emilerenaud/6DOF-Robotic-Arm/README.md

# 6DOF Robotic Arm

We are developing a 6 degree of freedom robotic arm based on an existing model (link for the model: https://www.thingiverse.com/thing:3327968). The project is still in development. The repo contains information about the components that were used, the code and the hardware.
