emilerenaud/6DOF-Robotic-Arm/Paperwork/Factures/commande stepper moteur aliexpress.png

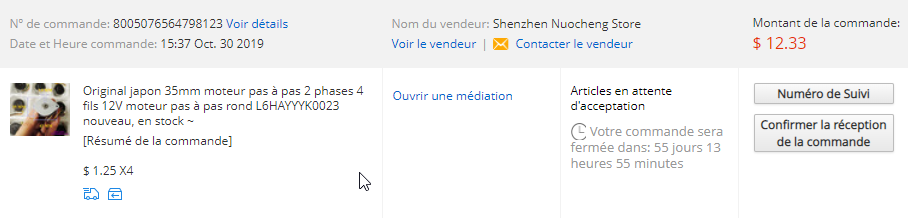
Paperwork/Factures/commande stepper moteur aliexpress.png
