emilerenaud/6DOF-Robotic-Arm/Paperwork/Factures/facture accesD stepper moteur aliexpress.png

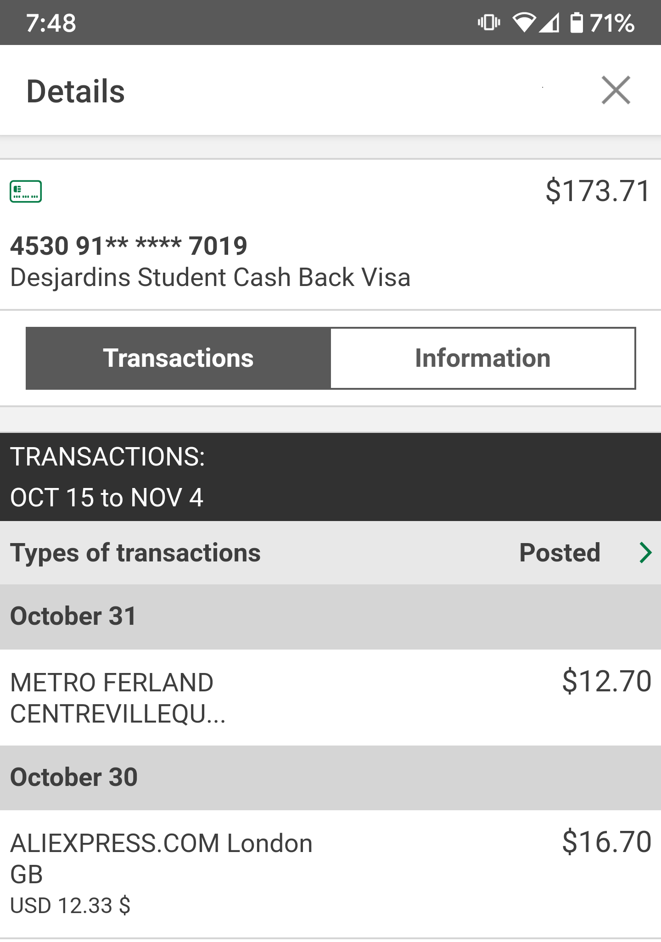
Paperwork/Factures/facture accesD stepper moteur aliexpress.png
