emilerenaud/6DOF-Robotic-Arm/Paperwork/Schémas/global.png

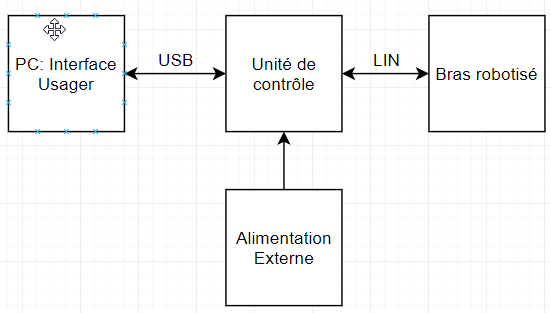
Paperwork/Schémas/global.png
