emilerenaud/6DOF-Robotic-Arm/Paperwork/Schémas/Hard BBB.png

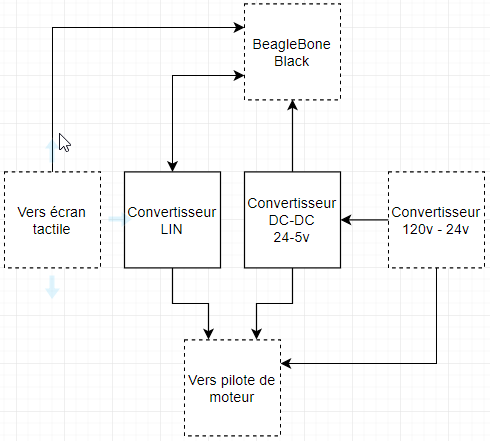
Paperwork/Schémas/Hard BBB.png
