emilerenaud/6DOF-Robotic-Arm/Paperwork/Schémas/soft User interface.png

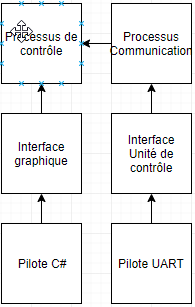
Paperwork/Schémas/soft User interface.png
