emilerenaud/6DOF-Robotic-Arm/Paperwork/Schémas/systeme coordonée.png

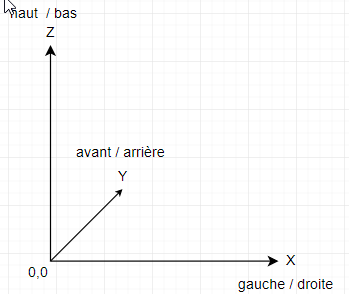
Paperwork/Schémas/systeme coordonée.png
