emilerenaud/6DOF-Robotic-Arm/Electronic/Components/Electronics-Components-Index.xlsx

Sheet: LISTE
Nom | Electronics Components & assemblies
Révision | 2020-04-08
Note | Emile Renaud
Number | Categories | Type | Name | Description | Manufacturier | DÉVELOPPEMENT | VERSION | Fournisseur Digikey | Price 1 | Fournisseur Bangood | Price 2
E-0001 | Library | * | Altium Library
E-0002 | Component | IC | ESP8266MOD | ESP-12E Wifi IC | N/A |  |  | N/A | $0.00 | 982886 (https://www.banggood.com/5Pcs-ESP8266-ESP-12E-Remote-Serial-Port-WIFI-Transceiver-Wireless-Module-p-982886.html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) | $2.94
E-0003 | Component | Sensor | LM335Z | TEMPERATURE SENSOR ANALOG -40C-100C TO92-3 | STMicroelectronics |  | VERSION\E-0003 | 497-1584-ND (https://www.digikey.ca/product-detail/en/stmicroelectronics/LM335Z/497-1584-ND/591686) | $0.78
E-0004 | Component | IC | TMC2130-TA-T | Bipolar Motor Driver Power MOSFET SPI, Step/Direction 48-TQFP-EP (7x7) | Trinamic Motion Control |  | VERSION\E-0004 | 1460-1186-1-ND (https://www.digikey.ca/product-detail/en/trinamic-motion-control-gmbh/TMC2130-TA-T/1460-1186-1-ND/6572873) | $7.96
E-0005 | Component | Regulator | AP2114H-3.3TRG1 | Linear Voltage Regulator IC 1 Output 1A SOT-223 | Diodes Incorporated |  | VERSION\E-0005 | AP2114H-3.3TRG1DICT-ND (https://www.digikey.ca/product-detail/en/diodes-incorporated/AP2114H-3.3TRG1/AP2114H-3.3TRG1DICT-ND/4505142) | $0.57
E-0006 | Component | Mosfet | 2N7002NXAKR | N-Channel 60V 190mA (Ta), SOT-23 | Nexperia USA Inc. |  | VERSION\E-0006 | 1727-8643-1-ND (https://www.digikey.ca/product-detail/en/nexperia-usa-inc/2N7002NXAKR/1727-8643-1-ND/10416560) | $0.15
E-0007 | Component | Mosfet | BUK9880-55A/CUX | N-Channel 55V 7A (Tc) 8W (Tc) Surface Mount SOT-223 | Nexperia USA Inc. |  | VERSION\E-0007 | 1727-2230-1-ND (https://www.digikey.ca/product-detail/en/nexperia-usa-inc/BUK9880-55A-CUX/1727-2230-1-ND/5361200) | $0.69
E-0008 | Component | Regulator | AS7805ADTR-G1 | Linear Voltage Regulator IC 1 Output 1A TO-252-2 | Diodes Incorporated |  | VERSION\E-0008 | AS7805ADTR-G1DICT-ND (https://www.digikey.ca/product-detail/en/diodes-incorporated/AS7805ADTR-G1/AS7805ADTR-G1DICT-ND/8545829) | $0.67
E-0009 | Component | Opto-isolator | MOC3023S-TA1 | OPTOISOLATOR 5KV TRIAC 6SMD | Lite-On Inc. |  | VERSION\E-0009 | 160-1894-1-ND (https://www.digikey.ca/product-detail/en/lite-on-inc/MOC3023S-TA1/160-1894-1-ND/3306760) | $0.96
E-0010 | Component | Connector | S3B-XH-A(LF)(SN) | CONN HEADER R/A 3POS 2.5MM | JST Sales America Inc. |  | VERSION\E-0010 | 455-2250-ND (https://www.digikey.ca/product-detail/en/jst-sales-america-inc/S3B-XH-A(LF)(SN)/455-2250-ND/1651048) | $0.34
E-0011 | Component | Connector | XHP-3 | CONN HOUSING 2.5MM XH 3POS | JST Sales America Inc. |  | VERSION\E-0011 | 455-2219-ND (https://www.digikey.ca/product-detail/en/jst-sales-america-inc/XHP-3/455-2219-ND/1651017) | $0.15
E-0012 | Component | Connector | S4B-XH-A(LF)(SN) | CONN HEADER R/A 4POS 2.5MM | JST Sales America Inc. |  | VERSION\E-0012 | 455-2243-ND (https://www.digikey.ca/product-detail/en/jst-sales-america-inc/S4B-XH-A(LF)(SN)/455-2243-ND/1651041) | $0.41
E-0013 | Component | Connector | XHP-4 | CONN HOUSING 2.5MM 4POS | JST Sales America Inc. |  | VERSION\E-0013 | 455-2267-ND (https://www.digikey.ca/product-detail/en/jst-sales-america-inc/XHP-4/455-2267-ND/683353) | $0.15
E-0014 | Component | Connector | S5B-XH-A-1(LF)(SN) | CONN HEADER R/A 5POS 2.5MM | JST Sales America Inc. |  | VERSION\E-0014 | 455-4228-ND (https://www.digikey.ca/product-detail/en/jst-sales-america-inc/S5B-XH-A-1(LF)(SN)/455-4228-ND/9961924) | $0.47
E-0015 | Component | Connector | XHP-5 | CONN HOUSING 2.5MM 5POS | JST Sales America Inc. |  | VERSION\E-0015 | 455-2268-ND (https://www.digikey.ca/product-detail/en/jst-sales-america-inc/XHP-5/455-2268-ND/1125486) | $0.18
E-0016 | Component | Connector | SXH-001T-P0.6 | CONN SOCKET 22-28AWG CRIMP TIN | JST Sales America Inc. |  | VERSION\E-0016 | 455-1135-1-ND (https://www.digikey.ca/product-detail/en/jst-sales-america-inc/SXH-001T-P0.6/455-1135-1-ND/527370) | $0.16
E-0017 | Component | Switch | PTS 647 SK50 SMTR2 LFS | TACT 4.5 X 4.5, 5.0 MM H, 2.5N, | C&K |  | VERSION\E-0017 | PTS647SK50SMTR2LFSCT-ND (https://www.digikey.ca/product-detail/en/c-k/PTS-647-SK50-SMTR2-LFS/PTS647SK50SMTR2LFSCT-ND/9649868) | $0.23
E-0018 | Component | Switch | PTS 647 SK70 SMTR2 LFS | TACT 4.5 X 4.5, 7.0 MM H, 2.5N, | C&K |  | VERSION\E-0018 | PTS647SK70SMTR2LFSCT-ND (https://www.digikey.ca/product-detail/en/c-k/PTS-647-SK70-SMTR2-LFS/PTS647SK70SMTR2LFSCT-ND/9649865) | $0.23
E-0019 | Component | IC | BM20SPKA1NBC-0001AA | RX TXRX MODULE BT TRC ANT SMD | Microchip Technology |  | VERSION\E-0019 | BM20SPKA1NBC-0001AA-ND (https://www.digikey.ca/product-detail/en/microchip-technology/BM20SPKA1NBC-0001AA/BM20SPKA1NBC-0001AA-ND/5323463) | $12.50
E-0020 | Component | Sensor | AH372-P-B | MAGNETIC SWITCH LATCH 3SIP | Diodes Incorporated |  | VERSION\E-0020 | AH372-P-BDI-ND (https://www.digikey.ca/products/en?keywords=621-AH372-P-B) | $1.32 | 1007581 (https://www.banggood.com/Hall-Sensor-Brushless-Motor-A3144-A3144E-OH3144E-Capteur-effet-TO-92UA-Interrupteur-3Pin-SIP-p-1007581.html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) | $1.90
E-0021 | Component | Connector | SFW15R-2STE1LF | CONN FFC FPC TOP 15POS 1MM R/A - Camera Raspberry pi | Amphenol ICC (FCI) |  | VERSION\E-0021 | 609-1906-1-ND (https://www.digikey.ca/product-detail/en/amphenol-icc-fci/SFW15R-2STE1LF/609-1906-1-ND/1003189) | $0.83
E-0022 | Component | PCB | PCB Extension Camera Raspi | PCB for cable extension - Raspberry pi Camera | Emile Renaud |  | VERSION\E-0022 | N/A | $0.00 | N/A | $0.00
E-0023 | Component | IC | STM32F103 | STM32F103C8T6 IC | STMicroelectronics |  | VERSION\E-0023 | 497-6063-ND (https://www.digikey.ca/product-detail/en/stmicroelectronics/STM32F103C8T6/497-6063-ND/1646338) | $8.02 | 1163842 (https://www.banggood.com/5Pcs-STM32F103C8T6-Small-System-Development-Board-Microcontroller-STM32-ARM-Core-Board-p-1163842.html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) | $4.24
E-0024 | Component | Resistor | RMCF1206JT33R0 | RES 33 OHM 5% 1/4W 1206 | Stackpole Electronics Inc |  | VERSION\E-0024 | RMCF1206JT33R0CT-ND (https://www.digikey.ca/product-detail/en/stackpole-electronics-inc/RMCF1206JT33R0/RMCF1206JT33R0CT-ND/1942758) | $0.16
E-0025 | Component | Resistor | RMCF1206JT10K0 | RES 10K OHM 5% 1/4W 1206 | Stackpole Electronics Inc |  | VERSION\E-0025 | RMCF1206JT10K0CT-ND (https://www.digikey.ca/product-detail/en/RMCF1206JT10K0/RMCF1206JT10K0CT-ND/1942803/?itemSeq=322558879) | $0.16
E-0026 | Component | Resistor | RK73B1JTTD102J | RES 1K OHM 5% 1/8W 0603 | KOA Speer Electronics, Inc. |  | VERSION\E-0026 | 2019-RK73B1JTTD102JCT-ND (https://www.digikey.ca/product-detail/en/RK73B1JTTD102J/2019-RK73B1JTTD102JCT-ND/9846742/?itemSeq=321579792) | $0.16
E-0027 | Component | Resistor | RMCF0603JT10K0 | RES 10K OHM 5% 1/10W 0603 | Stackpole Electronics Inc |  | VERSION\E-0027 | RMCF0603JT10K0CT-ND (https://www.digikey.ca/product-detail/en/RMCF0603JT10K0/RMCF0603JT10K0CT-ND/1943191/?itemSeq=321633246) | $0.16
E-0028 | Component | Resistor | RMCF0603JT4K70 | RES 4.7K OHM 5% 1/10W 0603 | Stackpole Electronics Inc |  | VERSION\E-0028 | RMCF0603JT4K70CT-ND (https://www.digikey.ca/product-detail/en/RMCF0603JT4K70/RMCF0603JT4K70CT-ND/1943184/?itemSeq=321633275) | $0.16
E-0029 | Component | Resistor | MCR03ERTJ3R3 | RES SMD 3.3 OHM 5% 1/10W 0603 | Rohm Semiconductor |  | VERSION\E-0029 | RHM3.3CGCT-ND (https://www.digikey.ca/product-detail/en/MCR03ERTJ3R3/RHM3.3CGCT-ND/4084417/?itemSeq=321633671) | $0.16
E-0030 | Component | Resistor | RK73B1JTTD620J | RES 62 OHM 5% 1/8W 0603 | KOA Speer Electronics, Inc. |  | VERSION\E-0030 | 2019-RK73B1JTTD620JCT-ND (https://www.digikey.ca/product-detail/en/RK73B1JTTD620J/2019-RK73B1JTTD620JCT-ND/9846834/?itemSeq=321672398) | $0.16
E-0031 | Component | Resistor | RMCF0603FG15K0 | RES 15K OHM 1% 1/10W 0603 | Stackpole Electronics Inc |  | VERSION\E-0031 | RMCF0603FG15K0CT-ND (https://www.digikey.ca/product-detail/en/RMCF0603FG15K0/RMCF0603FG15K0CT-ND/4425035/?itemSeq=321674385) | $0.16
E-0032 | Component | Resistor | RK73B1JTTD430J | RES 43 OHM 5% 1/8W 0603 | KOA Speer Electronics, Inc. |  | VERSION\E-0032 | 2019-RK73B1JTTD430JCT-ND (https://www.digikey.ca/product-detail/en/RK73B1JTTD430J/2019-RK73B1JTTD430JCT-ND/9846882/?itemSeq=321674550) | $0.16
E-0033 | Component | Capacitor | C0603C104Z3VACTU | CAP CER 0.1UF 25V Y5V 0603 | KEMET |  | VERSION\E-0033 | 399-1100-1-ND (https://www.digikey.ca/product-detail/en/C0603C104Z3VACTU/399-1100-1-ND/411375/?itemSeq=321556474) | $0.15
E-0034 | Component | Capacitor | CL10A105KA8NNNC | CAP CER 1UF 25V X5R 0603 | Samsung Electro-Mechanics |  | VERSION\E-0034 | 1276-1102-1-ND (https://www.digikey.ca/product-detail/en/CL10A105KA8NNNC/1276-1102-1-ND/3889188/?itemSeq=321556777) | $0.15
E-0035 | Component | Capacitor | C1206C104K5RAC7800 | CAP CER 0.1UF 50V X7R 1206 | KEMET |  | VERSION\E-0035 | 399-C1206C104K5RAC7800CT-ND (https://www.digikey.ca/product-detail/en/C1206C104K5RAC7800/399-C1206C104K5RAC7800CT-ND/411524/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) | $0.18
E-0036 | Component | LED | 150060VS75000 | LED GREEN CLEAR 0603 SMD | Würth Elektronik |  | VERSION\E-0036 | 732-4980-1-ND (https://www.digikey.ca/product-detail/en/150060VS75000/732-4980-1-ND/4489904/?itemSeq=321672215) | $0.21
E-0037 | Component | Connector | PRT-14322 | PHOTON STACKABLE HEADER - 12 PIN | SparkFun Electronics |  | VERSION\E-0037 | 1568-1651-ND (https://www.digikey.ca/product-detail/en/PRT-14322/1568-1651-ND/7364982/?itemSeq=321261024) | $0.76
E-0038 | Component | LED | 150505M173300 | LED RGB CLEAR 6PLCC SMD | Würth Elektronik |  | VERSION\E-0038 | 732-12000-2-ND (https://www.digikey.ca/products/en?keywords=732-12000-2-ND) | $0.50
E-0039 | Component | IC | MAX485CPA+-ND | IC TRANSCEIVER HALF 1/1 8DIP | Maxim Integrated |  | VERSION\E-0039 | MAX485CPA+-ND (https://www.digikey.ca/product-detail/en/maxim-integrated/MAX485CPA/MAX485CPA-ND/948026) | $5.10
E-0040 | Component | Crystal | ATS080B-E | CRYSTAL 8.0000MHZ 18PF T/H | CTS-Frequency Controls |  | VERSION\E-0040 | CTX917-ND (https://www.digikey.ca/product-detail/en/cts-frequency-controls/ATS080B-E/CTX917-ND/2292902) | $0.60
E-0041 | Component | Capacitor | C0603C220J1GACTU | CAP CER 22PF 100V C0G/NP0 0603 | KEMET |  | VERSION\E-0041 | 399-7874-1-ND (https://www.digikey.ca/product-detail/en/kemet/C0603C220J1GACTU/399-7874-1-ND/3471597) | $0.15
E-0042 | Component | Capacitor | C0603C223K1RACTU | CAP CER 0.022UF 100V X7R 0603 | KEMET |  | VERSION\E-0042 | 399-3476-1-ND (https://www.digikey.ca/product-detail/en/kemet/C0603C223K1RACTU/399-3476-1-ND/754769) | $0.15
E-0043 | Component | Capacitor | C0603C475K9PACTU | CAP CER 4.7UF 6.3V X5R 0603 | KEMET |  | VERSION\E-0043 | 399-3482-1-ND (https://www.digikey.ca/product-detail/en/kemet/C0603C475K9PACTU/399-3482-1-ND/754775) | $0.29
E-0044 | Component | Resistor | KDV06FR120ET | RES 120M OHM 1% 1/5W 0603 | Ohmite |  | VERSION\E-0044 | 273-KDV06FR120ETTR-ND (https://www.digikey.ca/en/products/detail/ohmite/KDV06FR120ET/10476537) | $0.47
E-0045 | Component | Resistor | CRCW060310M0FKEAC | RES 10M OHM 1% 1/10W 0603 | Vishay Dale |  | VERSION\E-0045 | 541-4048-2-ND (https://www.digikey.ca/en/products/detail/vishay-dale/CRCW060310M0FKEAC/7928470) | $0.16
E-0046 | Component | Regulator | RT9193-28GB | IC REG LINEAR 2.8V 300MA SOT23-5 | Richtek USA Inc. |  | VERSION\E-0046 | 1028-1072-2-ND (https://www.digikey.ca/product-detail/en/richtek-usa-inc/RT9193-28GB/1028-1072-2-ND/2546936) | $0.27
E-0047 | Component | Connector | 61300211121 | CONN HEADER 2POS 2.54MM | Würth Elektronik |  | VERSION\E-0047 | 732-5315-ND (https://www.digikey.ca/product-detail/en/w%C3%BCrth-elektronik/61300211121/732-5315-ND/4846823) | $0.20
E-0048 | Component | Connector | 61300411121 | CONN HEADER 4POS 2.54MM | Würth Elektronik |  | VERSION\E-0048 | 732-5317-ND (https://www.digikey.ca/product-detail/en/w%C3%BCrth-elektronik/61300411121/732-5317-ND/4846827) | $0.27
E-0049 | Component | Connector | GRPB032VWVN-RC | CONN HEADER VERT 6POS 1.27MM | Sullins Connector Solutions |  | VERSION\E-0049 | S9015E-03-ND (https://www.digikey.ca/product-detail/en/sullins-connector-solutions/GRPB032VWVN-RC/S9015E-03-ND/1786453) | $0.73
E-0050 | Component | Resistor | CRCW06031K60JNEA | RES SMD 1.6K OHM 5% 1/10W 0603 | Vishay Dale |  | VERSION\E-0050 | 541-1.6KGTR-ND (https://www.digikey.ca/en/products/detail/vishay-dale/CRCW06031K60JNEA/1174234) | $0.16
E-0051 | Component | Connector |  | Micro USB connector |  |  | VERSION\E-0051
E-0052 | Component | LED |  | Red LED 0603 SMD |  |  | VERSION\E-0052
E-0053 | Component | PCB | LCD Cape BeagleBone Black | LCD Cape + Max485 for BeagleBone Black | Emile Renaud |  | VERSION\E-0053 | N/A | $0.00 | N/A | $0.00
E-0054 | Component | PCB | PCB Drive Motor | PCB Drive motor for 6DOF Robotic Arm | Emile Renaud / Luka Bouchard |  | VERSION\E-0054 | N/A | Priceless | N/A
E-0055 | Component | Connector | Jumper 2 POS |  |  |  | VERSION\E-0055
E-0056 | Component | Resistor | RC0603JR-070RL | RES SMD 0 OHM JUMPER 1/10W 0603 | Yageo |  | VERSION\E-0056 | 311-0.0GRCT-ND (https://www.digikey.ca/product-detail/en/yageo/RC0603JR-070RL/311-0-0GRCT-ND/729622) | $0.16
E-0057 |  |  |  |  |  |  | VERSION\E-0057
E-0058 |  |  |  |  |  |  | VERSION\E-0058
E-0059 |  |  |  |  |  |  | VERSION\E-0059
E-0060 |  |  |  |  |  |  | VERSION\E-0060
E-0061 |  |  |  |  |  |  | VERSION\E-0061
E-0062 |  |  |  |  |  |  | VERSION\E-0062
E-0063 |  |  |  |  |  |  | VERSION\E-0063
E-0064 |  |  |  |  |  |  | VERSION\E-0064
E-0065 |  |  |  |  |  |  | VERSION\E-0065
E-0066 |  |  |  |  |  |  | VERSION\E-0066
E-0067 |  |  |  |  |  |  | VERSION\E-0067
E-0068 |  |  |  |  |  |  | VERSION\E-0068
E-0069 |  |  |  |  |  |  | VERSION\E-0069
E-0070 |  |  |  |  |  |  | VERSION\E-0070
E-0071 |  |  |  |  |  |  | VERSION\E-0071
E-0072 |  |  |  |  |  |  | VERSION\E-0072
E-0073 |  |  |  |  |  |  | VERSION\E-0073
E-0074 |  |  |  |  |  |  | VERSION\E-0074
E-0075 |  |  |  |  |  |  | VERSION\E-0075
E-0076 |  |  |  |  |  |  | VERSION\E-0076
E-0077 |  |  |  |  |  |  | VERSION\E-0077
E-0078 |  |  |  |  |  |  | VERSION\E-0078
E-0079 |  |  |  |  |  |  | VERSION\E-0079
E-0080 |  |  |  |  |  |  | VERSION\E-0080
E-0081 |  |  |  |  |  |  | VERSION\E-0081
E-0082 |  |  |  |  |  |  | VERSION\E-0082
E-0083 |  |  |  |  |  |  | VERSION\E-0083
E-0084 |  |  |  |  |  |  | VERSION\E-0084
E-0085 |  |  |  |  |  |  | VERSION\E-0085
E-0086 |  |  |  |  |  |  | VERSION\E-0086
E-0087 |  |  |  |  |  |  | VERSION\E-0087
E-0088 |  |  |  |  |  |  | VERSION\E-0088
E-0089 |  |  |  |  |  |  | VERSION\E-0089

Sheet: CATÉGORIES & TYPES
Catégorie | Description | Exemple
Modèle | modèle à utiliser pour la création de documents | modèle de schéma de format "A" avec cartouche normalisée
Exemple | exemple d'utilisation d'éléments de conception | exemple de schéma de format "A" créé à partir du modèle approprié
Composant | Composant électronique | résistance, transistor, circuit imprimé, connecteurs, etc
Librairie | Librairie de composants électroniques | librairie de composants pour un logiciel de dessin de schémas électriques
Assemblage | Assemblage de composants | circuit imprimé sur lequel des pièces ont été soudées et/ou vissées
Mécanique | Composant mécanique | fichiers qui permettent voir un microprocesseur et les circuits qui lui sont connectés comme un seul et même circuit avec lequel un module d'interface peut interagir
Document | Document associé à un produit | fichier qui contient plusieurs fonctions génériques
Ressource | Éléments utilisés pour la création des schémas et assemblage | fichiers contenant des images qui sont reproduites sur des circuits imprimés (logo de compagnie, marques d'approbation)
Externe | Élements utiles provenant de sources externes | librairie de pièces, normes, notes d'application
* | à définir | à utiliser pour indiquer que l'élément n'a pas encore été classifié
Type
Resistor
Inductance
Capacitor
Diode
Mosfet
Transistor
LED
Crystal
Batterie
Switch
Connector
Regulator
IC
Assembly
Motor
Opto-isolator
Sensor
PCB
*
