emilerenaud/6DOF-Robotic-Arm/Electronic/PCB/Motor Driver/2020_03_26/Motor Driver/Project Outputs for Motor Driver/BOM-Motor_Driver_V0.1.xls

Sheet: BOM Report
Bill of Materials |  |  | Bill of Materials for Project [Motor Driver.PrjPcb] (No PCB Document Selected)
Source Data From: |  | Motor Driver.PrjPcb
Project: |  | Motor Driver.PrjPcb
Variant: |  | None
Creation Date: | 4/21/2020 | 8:14 PM
Print Date: | 2020-04-21 | 20:14:45
Footprint | Comment | LibRef | Designator | Description | Quantity
PAD |  | PAD | RST | SMD Pad for contact | 1
603 | Jumper | Jumper | R9, R11, R13, R14, R15, R18, R19 | Jumper 0603 | 7
TO92 | LM335Z | E-0003 | U6 | Temperature Sensor LM335Z | 1
eTQFP48_9x9 | TMC2130-TA | E-0004 | U2 | Motor Driver TMC2130-TA | 1
SOT223_M | E-0007 | E-0007 | Q1 | 55V 7A SOT223 | 1
JST 4POS 2.5mm 90° | E-0012 | E-0012 | J6 | Connector JST 4POS | 1
JST 5POS 2.5mm 90° | MAIN_IN | E-0014 | J2 | Connector JST 5POS | 1
JST 5POS 2.5mm 90° | MAIN_OUT | E-0014 | J3 | Connector JST 5POS | 1
AH372PB | Hall Sensor | E-0020 | U5 | Hall Sensor | 1
LQFP-48 | STM32F103C8T6 | E-0023 | U1 | STM32F103C8T6 Bluepill | 1
603 | E-0026 | E-0026 | R16, R17 | 1K Resistor 0603 SMD | 2
603 | E-0027 | E-0027 | R3 | 10K Resistor 0603 SMD | 1
603 | Resistor 0603 | E-0027 | R4, R10 | 10K Resistor 0603 SMD | 2
603 | E-0029 | E-0029 | R5, R7 | 3.3R Resistor 0603 SMD | 2
603 | E-0031 | E-0031 | R12 | 15K Resistor 0603 SMD | 1
603 | E-0032 | E-0032 | R6 | 43R Resistor 0603 SMD | 1
603 | E-0033 | E-0033 | C1, C2, C3, C4, C8, C10, C13, C14, C15, C16, C17, C18, C19, C20, C21, C23 | 0.1uF Capacitor 0603 SMD | 16
603 | E-0034 | E-0034 | C5, C6, C9 | 1uf Capacitor 0603 SMD | 3
LED 5050 | LED RGB 5050 | E-0038 | D1 | LED RGB 5050 | 1
DIP 8 - 3D | MAX485EPA | E-0039 | U3 | RS485 Communication | 1
ATS080B-E | 8M | E-0040 | Y1 | Crystal 8M | 1
603 | E-0041 | E-0041 | C11, C12 | 22pF Capacitor 0603 SMD | 2
603 | E-0042 | E-0042 | C7 | 22nF Capacitor 0603 SMD | 1
603 | E-0043 | E-0043 | C22 | 4.7uF Capacitor 0603 SMD | 1
603 | E-0044 | E-0044 | R1 | 120R Resistor 0603 SMD | 1
603 | E-0045 | E-0045 | R8 | 10M Resistor 0603 SMD | 1
SOT94P279X130-5N | 3.3V regulator | E-0046 | U4 | Voltage Regulator 3.3V SOT-23-5 | 1
HDR1X2 | FAN | E-0047 | J4 | Header, 2-Pin | 1
HDR1X4 | SWD | E-0048 | J1 | Header, 4POS | 1
Header 3x2 1.27mm SMD | BOOT | E-0049 | J5 | Header, 3-Pin, Dual row | 1
603 | E-0050 | E-0050 | R2 | 1.6K Resistor 0603 SMD | 1
 |  |  |  |  | 58
Approved |  | Notes

Sheet: Project Information
Project Full Path | C:\Users\Emile\master\Electronic\PCB\Motor Driver\2020_03_26\Motor Driver\Motor Driver.PrjPcb
Project Filename | Motor Driver.PrjPcb
Variant Name | None
Data-Source Filename | Motor Driver.PrjPcb
Data-Source Full Path | C:\Users\Emile\master\Electronic\PCB\Motor Driver\2020_03_26\Motor Driver\Motor Driver.PrjPcb
Title | Bill of Materials for Project [Motor Driver.PrjPcb] (No PCB Document Selected)
Total Quantity | 58
Report Time | 8:14 PM
Report Date | 4/21/2020
Report Date & Tine | 4/21/2020 8:14 PM
Output Name | Bill of Materials
Output Type | BOM_PartType
Output Generator Name | BOM
Output Generator Description | Bill of Materials
