emilerenaud/6DOF-Robotic-Arm/Electronic/PCB/Motor Driver/2020_03_26/Motor Driver/Project Outputs for Motor Driver/Motor Driver.xls

Sheet: BOM Report
Bill of Materials |  |  | Bill of Materials for Project [Motor Driver.PrjPcb] (No PCB Document Selected)
Source Data From: |  | Motor Driver.PrjPcb
Project: |  | Motor Driver.PrjPcb
Variant: |  | None
Creation Date: | 4/21/2020 | 3:37 PM
Print Date: | 2020-04-21 | 15:37:34
Footprint | Comment | LibRef | Designator | Description | Quantity
 | Header 23x2 | Header 23x2 |  |  | 1
603 | Capacitor SMD | Capacitor SMD | C1, C2, C3, C4, C5, C6, C7, C8, C9, C10, C11, C12, C13, C14, C15, C16, C17, C18, C19, C20, C21, C22, C23 | Capacitor SMD 0603 | 23
LED 5050 | LED RGB 5050 | 150505M173300 | D1 | LED | 1
HDR1X4 | SWD-PROG | Header 4 | J1 | Header, 4-Pin | 1
JST 5POS 2.5mm 90° | MAIN_IN | JST 5POS | J2 | Connector | 1
JST 5POS 2.5mm 90° | MAIN_OUT | JST 5POS | J3 | Connector | 1
HDR1X2 | FAN | Header 2 | J4 | Header, 2-Pin | 1
Header 3x2 1.27mm SMD | BOOT | Header 3X2 | J5 | Header, 3-Pin, Dual row | 1
JST 4POS 2.5mm 90° | MOTOR | JST 4POS | J6 | Connector | 1
SOT223_M | MOSFET N-CH | MOSFET N-CH | Q1 | 55V 7A SOT223 | 1
603 | Resistor 0603 | Resistor 0603 | R1, R2, R3, R5, R6, R7, R8, R9, R10, R11, R12, R13, R14, R15, R16, R17, R18, R19 | Resistor 0603 SMD | 18
603 | R10K_0603 | R10K_0603 | R4 | Resistor 0603 SMD | 1
RES1206 | Resistor 1206 | Resistor 1206 | R? | Resistor 1206 SMD | 1
PAD | PAD RST | PAD | RST | SMD Pad for contact | 1
LQFP-48 | STM32F103C8T6 | STM32F103C8T6 | U1 | Integrated Circuit STM32 | 1
eTQFP48_9x9 | TMC2130-TA | TMC2130-TA | U2 | Motor Driver TMC2130 | 1
DIP 8 - 3D | MAX485CPA+ | MAX485CPA+ | U3 | RS485 Communication | 1
SOT94P279X130-5N | RT9193-28GB | RT9193-28GB | U4 | Voltage Regulator 3.3V | 1
AH372PB | AH372-P-B | AH372-P-B | U5 | Hall Sensor | 1
TO92 | LM335Z | LM335Z | U6 | Temperature Sensor | 1
U_BM20SPKA | BM20SPKA1NBC-0001AA | BM20 | U? |  | 1
 | ESP-12E | ESP-12E | U? |  | 1
ATS080B-E | 8M | XTAL | Y1 | Crystal Oscillator | 1
 |  |  |  |  | 62
Approved |  | Notes

Sheet: Project Information
Project Full Path | C:\Users\Emile\master\Electronic\PCB\Motor Driver\2020_03_26\Motor Driver\Motor Driver.PrjPcb
Project Filename | Motor Driver.PrjPcb
Variant Name | None
Data-Source Filename | Motor Driver.PrjPcb
Data-Source Full Path | C:\Users\Emile\master\Electronic\PCB\Motor Driver\2020_03_26\Motor Driver\Motor Driver.PrjPcb
Title | Bill of Materials for Project [Motor Driver.PrjPcb] (No PCB Document Selected)
Total Quantity | 62
Report Time | 3:37 PM
Report Date | 4/21/2020
Report Date & Tine | 4/21/2020 3:37 PM
Output Name | Bill of Materials
Output Type | BOM_PartType
Output Generator Name | BOM
Output Generator Description | Bill of Materials
