emilerenaud/6DOF-Robotic-Arm/Electronic/PCB/Motor Driver/2020_03_26/Motor Driver/PCB1.step

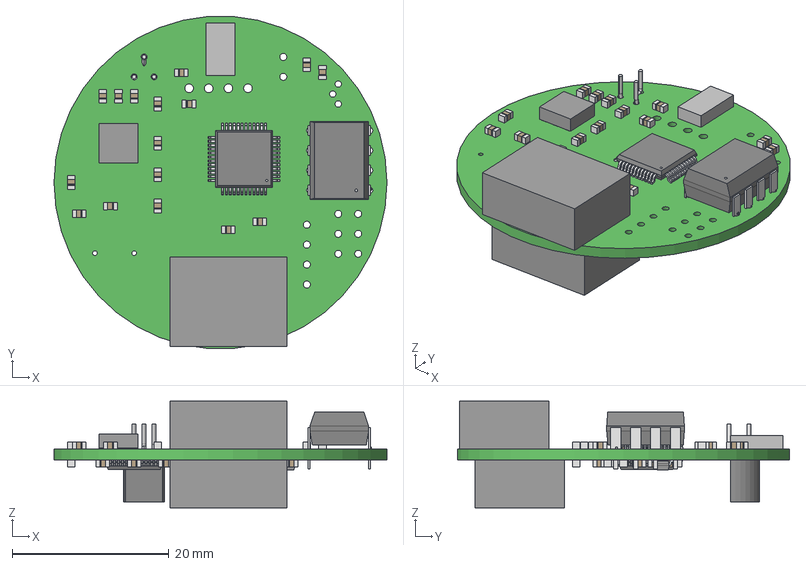
[picture p25: CAD file, 2020-04-01]
Electronic/PCB/Motor Driver/2020_03_26/Motor Driver/PCB1.step
42.4 x 42.3 x 13.6 mm
PinsArrayL
PinsArrayR
MAX485
Extruded x 36
Leads x 20
LM335Z
TMC2130
STM32F103C8T6
('pin',_'1') x 2
('pin',_'2') x 2
('pin',_'3') x 2
('pin',_'4') x 2
('pin',_'5') x 2
('pin',_'6') x 2
