emilerenaud/6DOF-Robotic-Arm/Mechanic/STL/Arm/elbowshell.STL

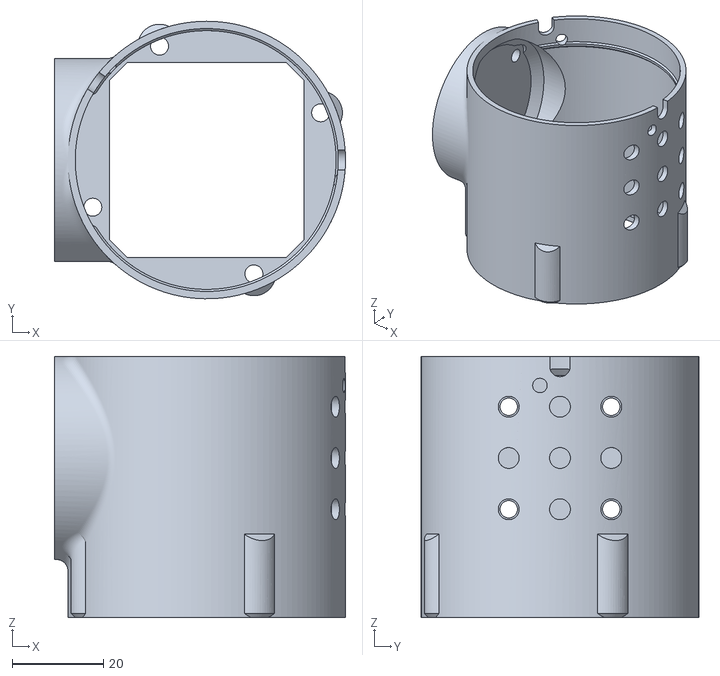
[picture p26: CAD file, 2020-04-01]
Mechanic/STL/Arm/elbowshell.STL
63.7 x 60.8 x 57.1
