emilerenaud/6DOF-Robotic-Arm/Mechanic/STL/big planetary/body20.STL

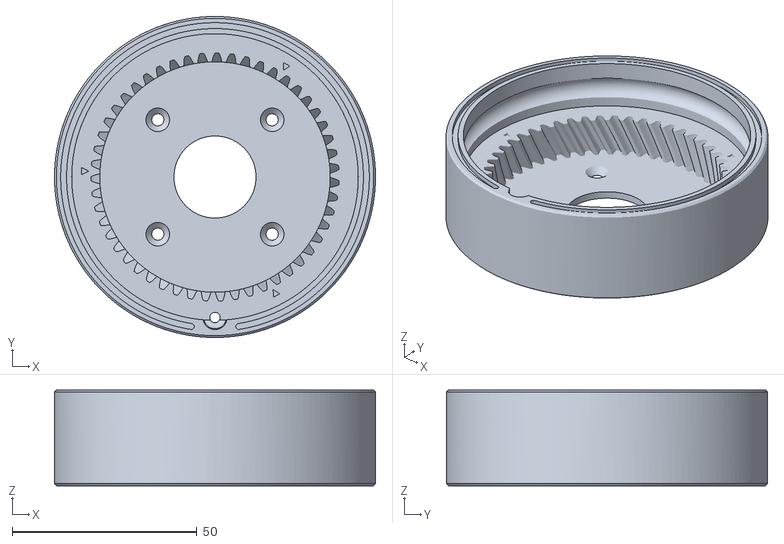
[picture p27: CAD file, 2020-04-01]
Mechanic/STL/big planetary/body20.STL
87.0 x 87.0 x 26.0
