emilerenaud/6DOF-Robotic-Arm/Mechanic/STL/Gripper/Joint To Axis.stl

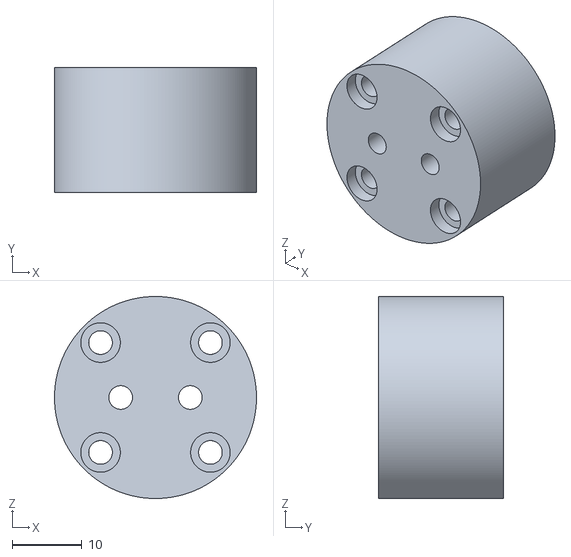
[picture p28: CAD file, 2020-04-01]
Mechanic/STL/Gripper/Joint To Axis.stl
29.0 x 18.0 x 29.0
