emilerenaud/6DOF-Robotic-Arm/Mechanic/STL/Small planetary/Sun18H40.STL

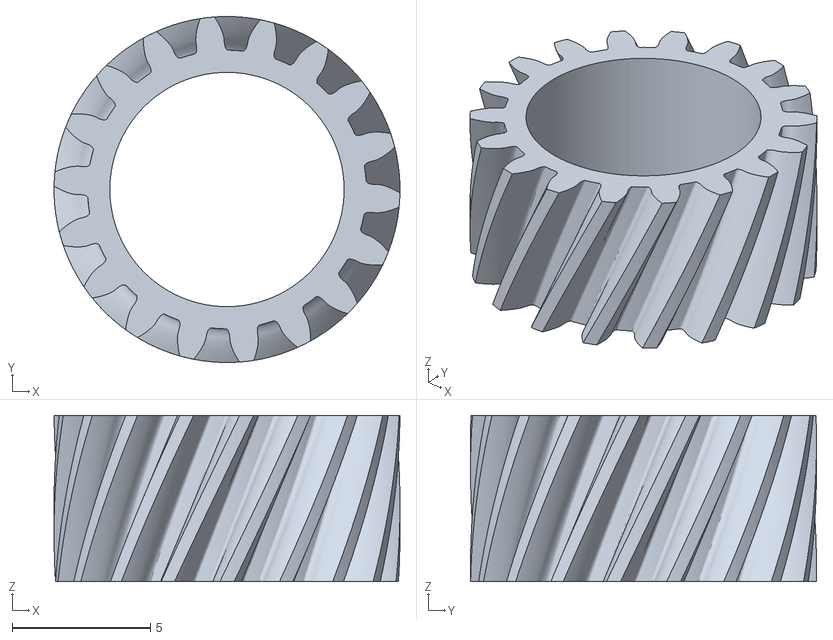
[picture p29: CAD file, 2020-04-01]
Mechanic/STL/Small planetary/Sun18H40.STL
12.5 x 12.5 x 6.00
