emilerenaud/6DOF-Robotic-Arm/Mechanic/STL/Arm/TicBaseCover.STL

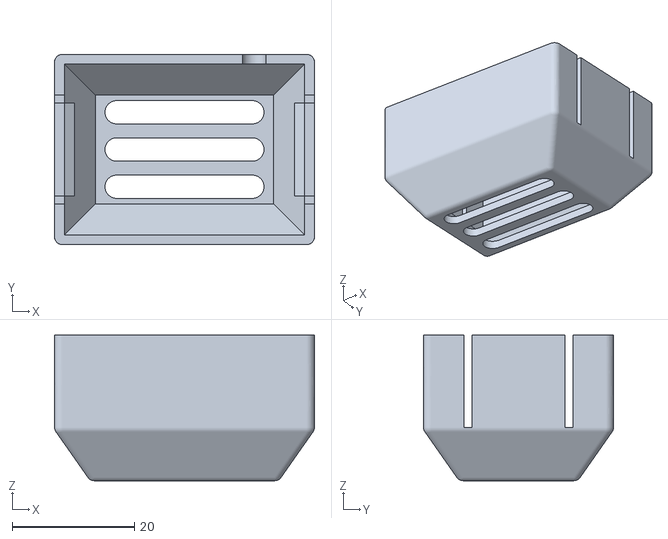
[picture p30: CAD file, 2020-04-01]
Mechanic/STL/Arm/TicBaseCover.STL
42.6 x 31.1 x 23.8
