emilerenaud/6DOF-Robotic-Arm/Mechanic/STL/Gripper/Left Gripper.stl

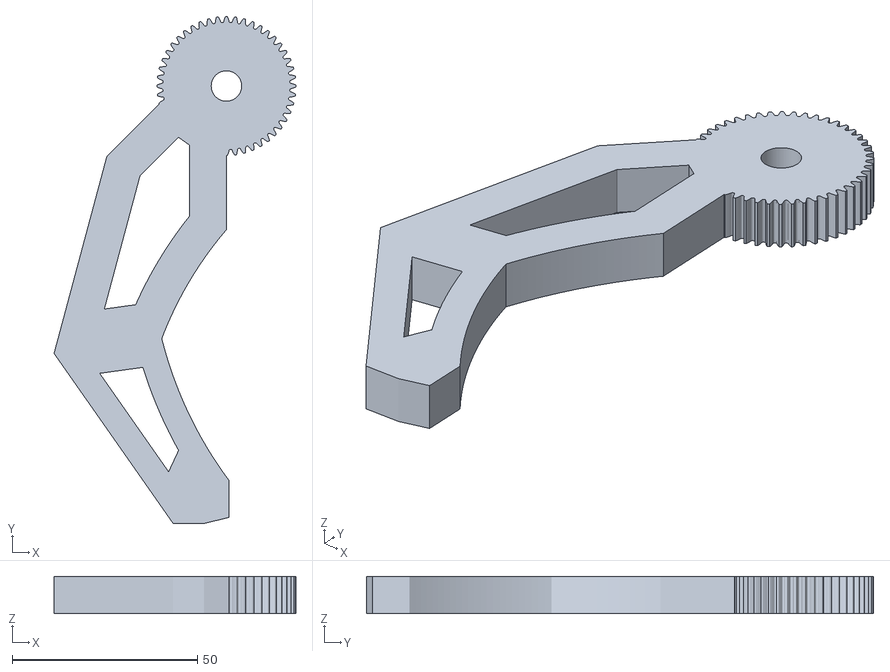
[picture p31: CAD file, 2020-04-01]
Mechanic/STL/Gripper/Left Gripper.stl
65.2 x 136.7 x 10.0
