emilerenaud/6DOF-Robotic-Arm/Mechanic/STL/Small planetary/PlanetClusterH40.STL

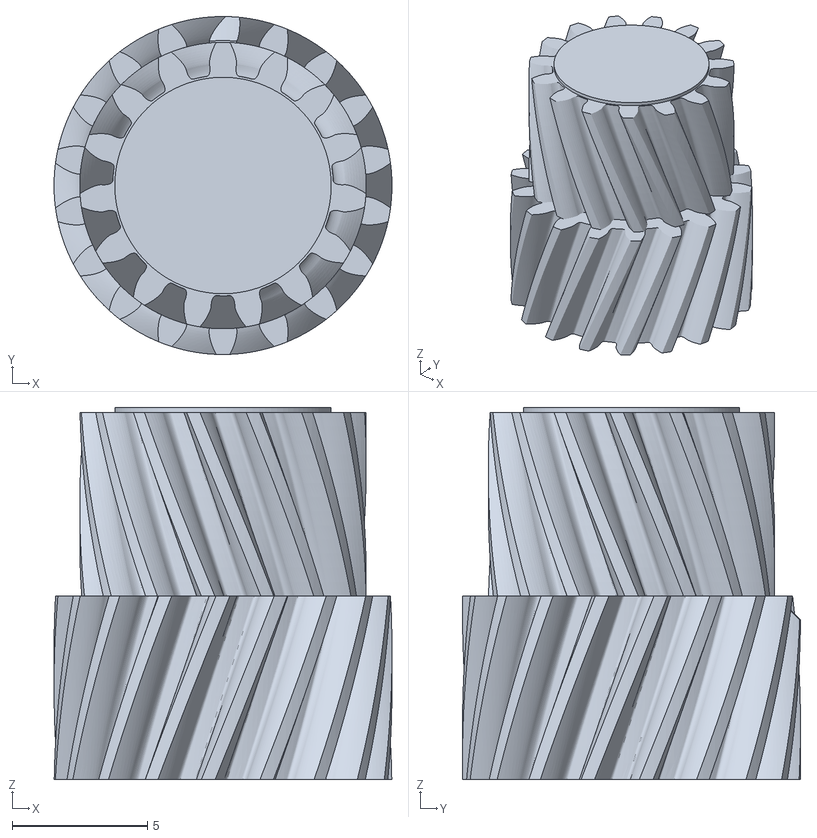
[picture p32: CAD file, 2020-04-01]
Mechanic/STL/Small planetary/PlanetClusterH40.STL
12.5 x 12.5 x 13.8
