emilerenaud/6DOF-Robotic-Arm/Mechanic/STL/Arm/UpperArm_short.STL

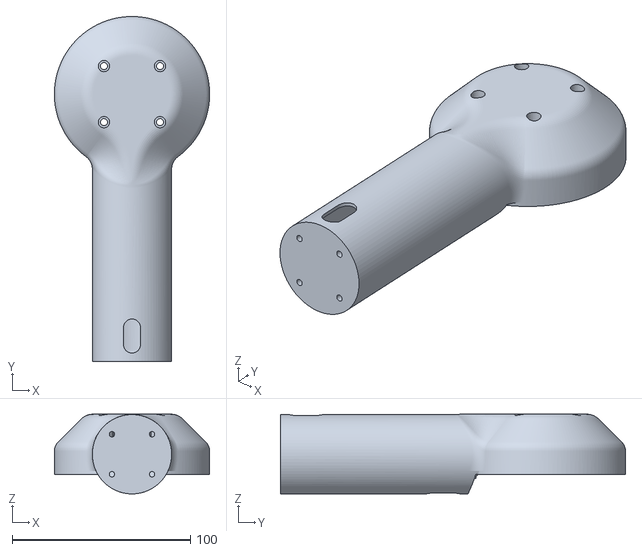
[picture p33: CAD file, 2020-04-01]
Mechanic/STL/Arm/UpperArm_short.STL
87.0 x 193.4 x 44.7
