emilerenaud/6DOF-Robotic-Arm/Mechanic/STL/Gripper/Servo Cover.stl

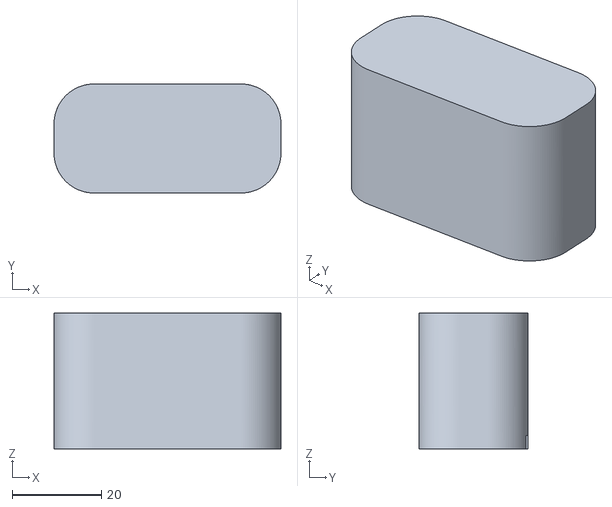
[picture p34: CAD file, 2020-04-01]
Mechanic/STL/Gripper/Servo Cover.stl
51.0 x 24.5 x 30.5
