emilerenaud/6DOF-Robotic-Arm/Mechanic/STL/Small planetary/Ring48H40.STL

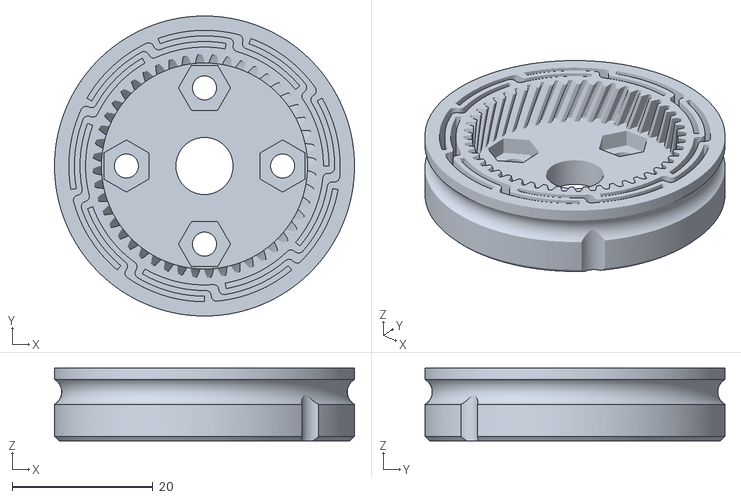
[picture p35: CAD file, 2020-04-01]
Mechanic/STL/Small planetary/Ring48H40.STL
42.7 x 42.7 x 10.4
