emilerenaud/6DOF-Robotic-Arm/Mechanic/STL/Arm/UpperArm.STL

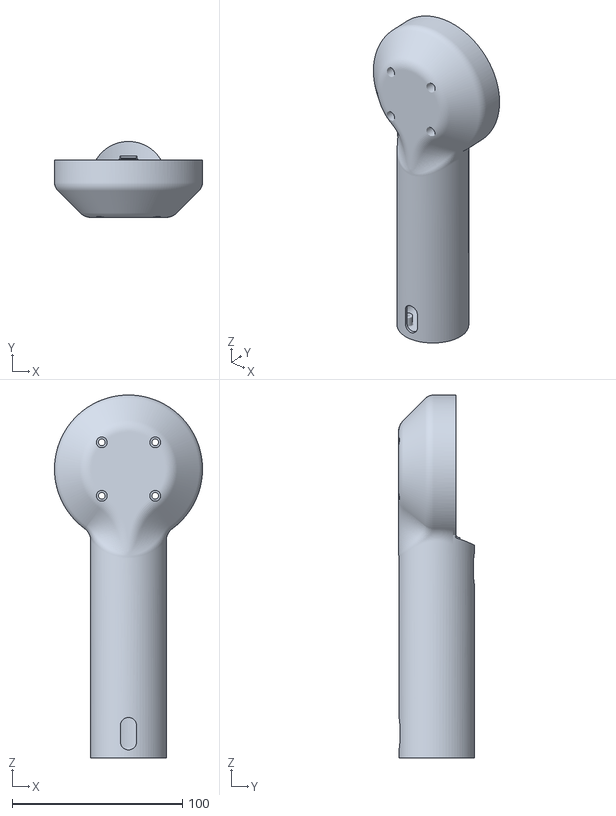
[picture p36: CAD file, 2020-04-01]
Mechanic/STL/Arm/UpperArm.STL
87.0 x 44.7 x 213.4
