emilerenaud/6DOF-Robotic-Arm/Mechanic/STL/Gripper/Right Gripper.stl

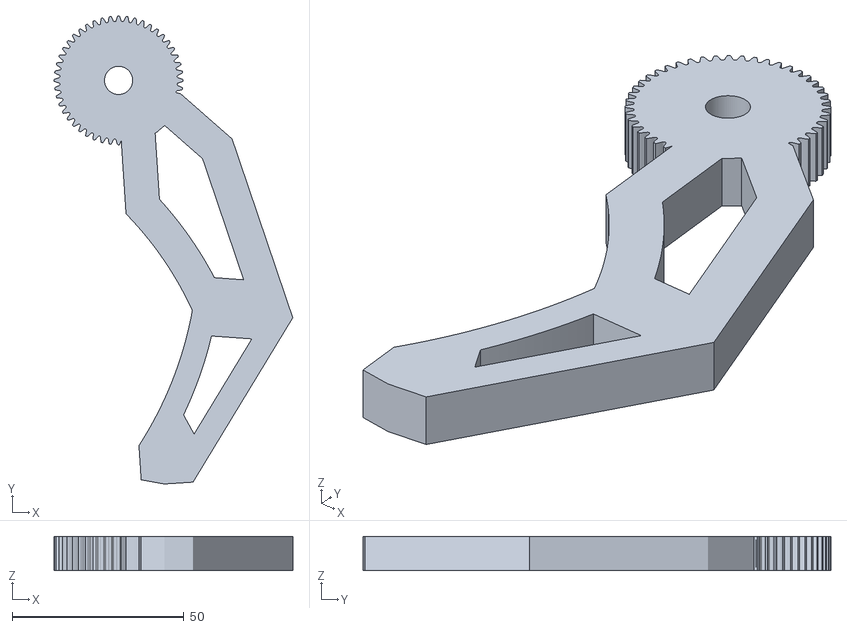
[picture p37: CAD file, 2020-04-01]
Mechanic/STL/Gripper/Right Gripper.stl
69.5 x 136.3 x 10.0
