emilerenaud/6DOF-Robotic-Arm/Mechanic/STL/Small planetary/bodyH40.STL

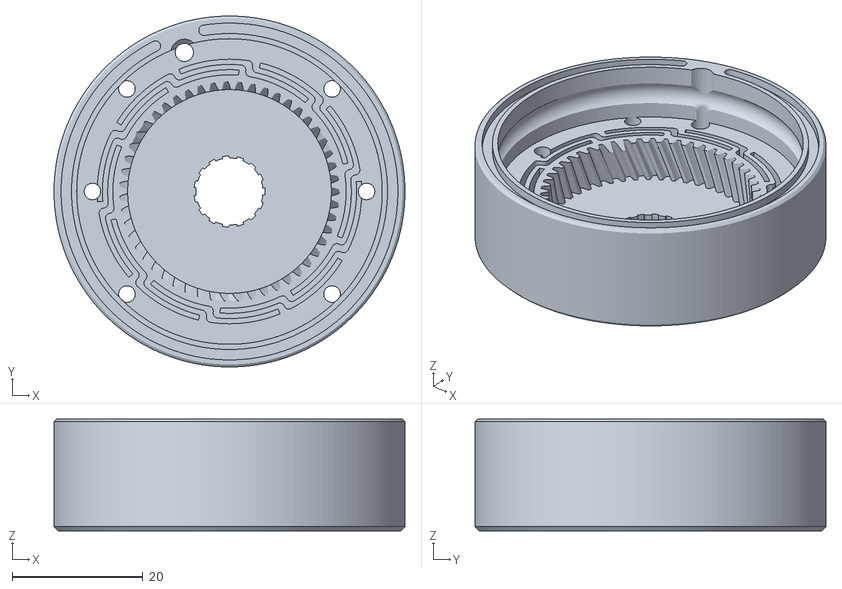
[picture p38: CAD file, 2020-04-01]
Mechanic/STL/Small planetary/bodyH40.STL
53.8 x 53.8 x 17.1
