emilerenaud/6DOF-Robotic-Arm/Mechanic/STL/Arm/wristshell.STL

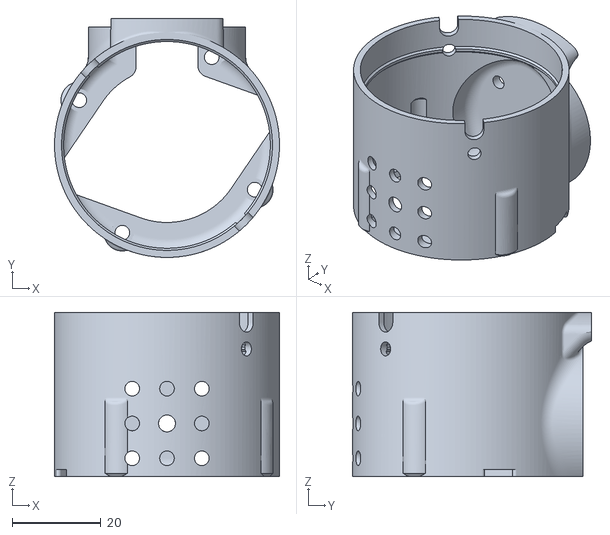
[picture p39: CAD file, 2020-04-01]
Mechanic/STL/Arm/wristshell.STL
50.8 x 53.9 x 37.1
