emilerenaud/6DOF-Robotic-Arm/Mechanic/STL/Gripper/Driving Gear.stl

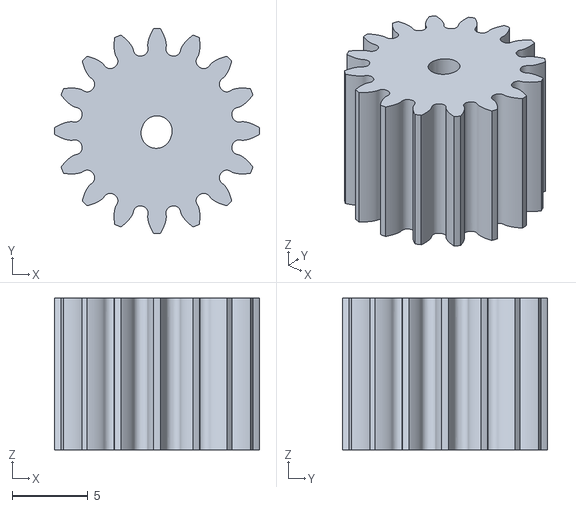
[picture p40: CAD file, 2020-04-01]
Mechanic/STL/Gripper/Driving Gear.stl
13.5 x 13.5 x 10.0
