emilerenaud/6DOF-Robotic-Arm/Mechanic/STL/Small planetary/Sun15H40.STL

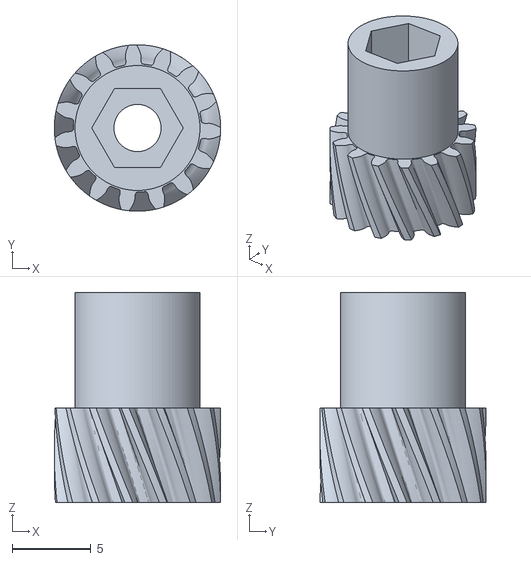
[picture p41: CAD file, 2020-04-01]
Mechanic/STL/Small planetary/Sun15H40.STL
10.6 x 10.6 x 13.4
