emilerenaud/6DOF-Robotic-Arm/Mechanic/STL/Arm/shouldercap.STL

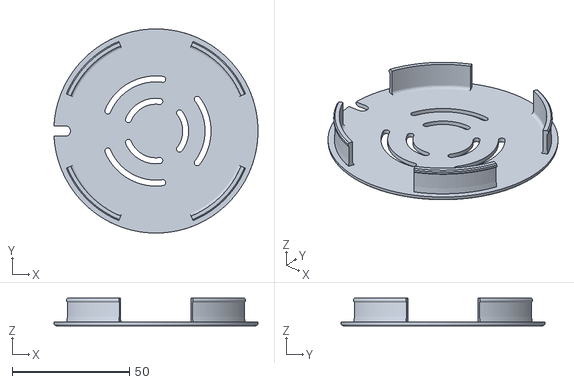
[picture p42: CAD file, 2020-04-01]
Mechanic/STL/Arm/shouldercap.STL
87.0 x 87.0 x 11.8
