emilerenaud/6DOF-Robotic-Arm/Mechanic/STL/Gripper/Gripper Case.stl

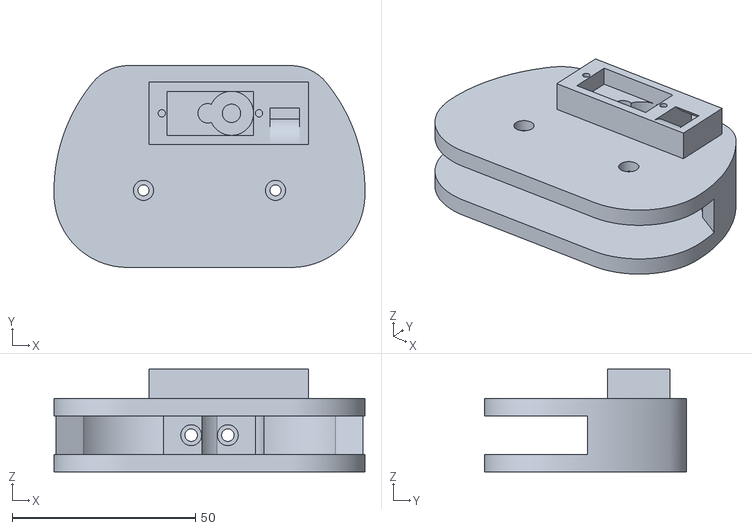
[picture p43: CAD file, 2020-04-01]
Mechanic/STL/Gripper/Gripper Case.stl
84.8 x 55.0 x 28.0
