emilerenaud/6DOF-Robotic-Arm/Mechanic/STL/Arm/shouldershell.STL

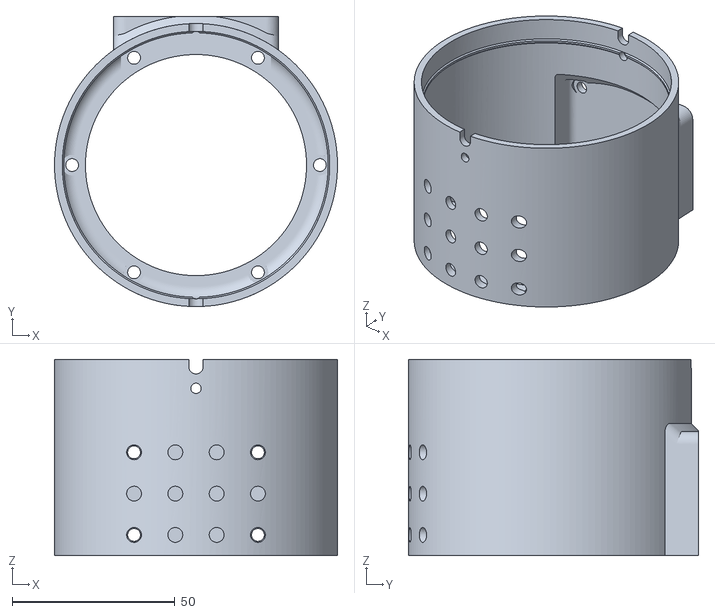
[picture p44: CAD file, 2020-04-01]
Mechanic/STL/Arm/shouldershell.STL
87.0 x 89.2 x 60.3
