emilerenaud/6DOF-Robotic-Arm/Mechanic/STL/Arm/TicBase.STL

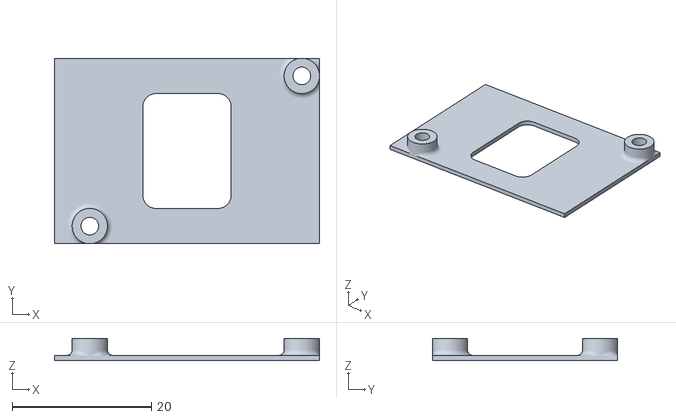
[picture p45: CAD file, 2020-04-01]
Mechanic/STL/Arm/TicBase.STL
38.1 x 26.7 x 3.17
