emilerenaud/6DOF-Robotic-Arm/Mechanic/STL/Arm/elbowcap.STL

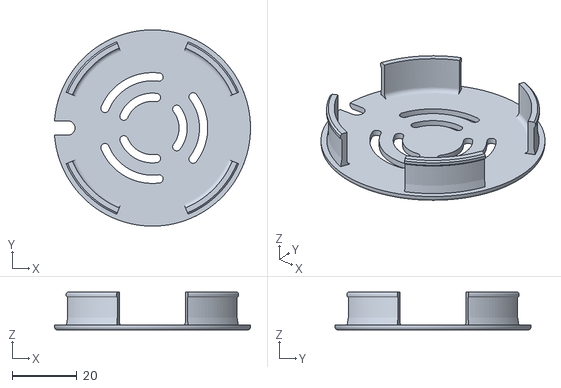
[picture p46: CAD file, 2020-04-01]
Mechanic/STL/Arm/elbowcap.STL
60.7 x 60.8 x 11.8
