emilerenaud/6DOF-Robotic-Arm/Mechanic/STL/Arm/wristcap.STL

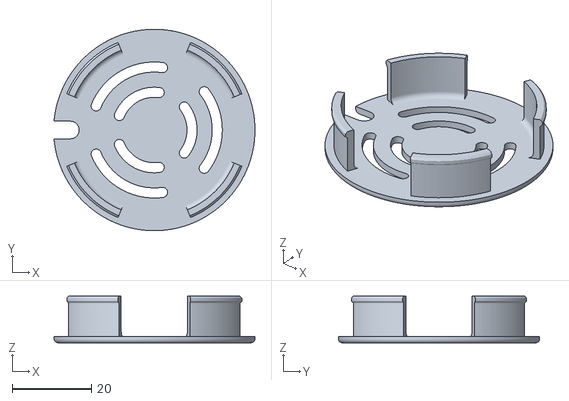
[picture p47: CAD file, 2020-04-01]
Mechanic/STL/Arm/wristcap.STL
50.7 x 50.8 x 11.8
