emilerenaud/6DOF-Robotic-Arm/Mechanic/STL/Arm/shoulderplate.STL

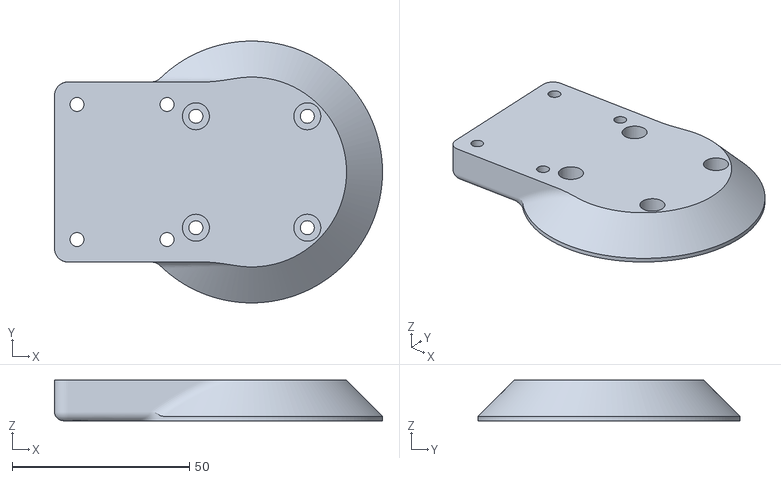
[picture p48: CAD file, 2020-04-01]
Mechanic/STL/Arm/shoulderplate.STL
92.5 x 73.9 x 11.4
