emilerenaud/6DOF-Robotic-Arm/Mechanic/STL/Arm/basecone.STL

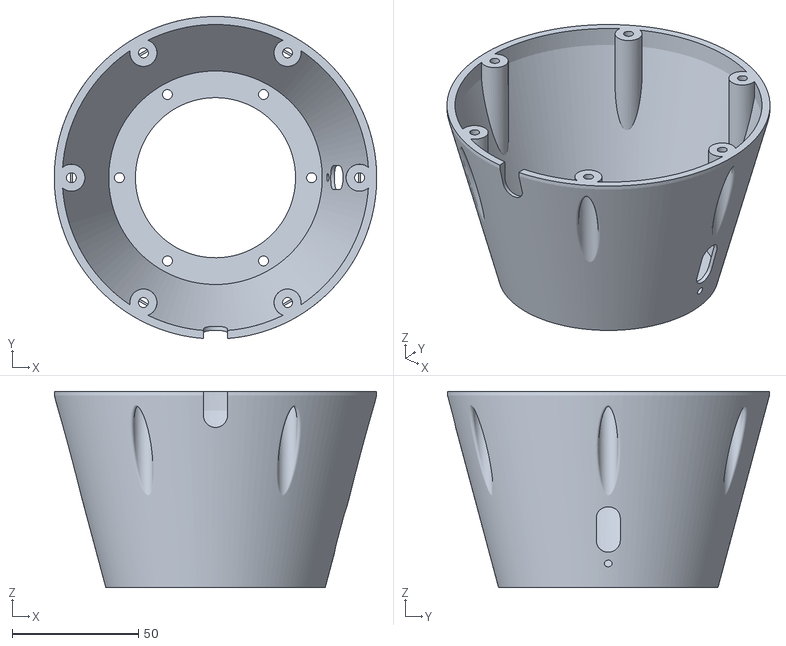
[picture p49: CAD file, 2020-04-01]
Mechanic/STL/Arm/basecone.STL
127.9 x 127.7 x 77.8
