emilerenaud/6DOF-Robotic-Arm/Mechanic/STL/Arm/Forearm.STL

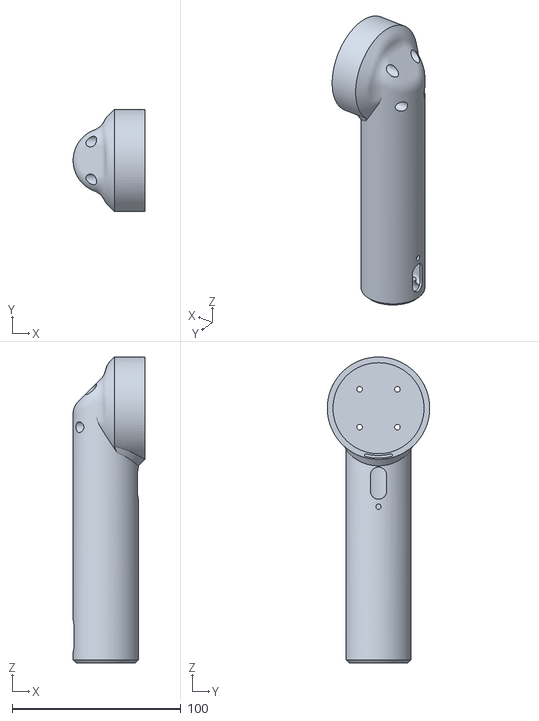
[picture p50: CAD file, 2020-04-01]
Mechanic/STL/Arm/Forearm.STL
42.6 x 60.8 x 181.5
