emilerenaud/6DOF-Robotic-Arm/(list of files, cad)

Other CAD files:
Mechanic/LCD/top lcd mount.ipt
