emilerenaud/6DOF-Robotic-Arm/(list of files, drawings)

Other design files:
Electronic/PCB/LCD Cape BBB/2020-03-18/LCD Cape BBB.PrjPcb
Electronic/PCB/LCD Cape BBB/2020-03-18/LCD Cape.SchDoc
Electronic/PCB/LCD Cape BBB/2020-03-18/PCB1.PcbDoc
Electronic/PCB/LCD Cape BBB/Backup/2020-03-06-1/LCD Cape BBB.PrjPcb
Electronic/PCB/LCD Cape BBB/Backup/2020-03-06-1/LCD Cape.SchDoc
Electronic/PCB/LCD Cape BBB/Backup/2020-03-06-1/PCB1.PcbDoc
Electronic/PCB/LCD Cape BBB/Backup/2020-03-06/LCD Cape BBB.PrjPcb
Electronic/PCB/LCD Cape BBB/Backup/2020-03-06/LCD Cape.SchDoc
Electronic/PCB/LCD Cape BBB/Backup/2020-03-06/PCB1.PcbDoc
Electronic/PCB/LCD Cape BBB/Backup/2020-03-11/LCD Cape BBB.PrjPcb
Electronic/PCB/LCD Cape BBB/Backup/2020-03-11/LCD Cape.SchDoc
Electronic/PCB/LCD Cape BBB/Backup/2020-03-11/PCB1.PcbDoc
Electronic/PCB/LCD Cape BBB/Backup/2020-03-16/LCD Cape BBB.PrjPcb
Electronic/PCB/LCD Cape BBB/Backup/2020-03-16/LCD Cape.SchDoc
Electronic/PCB/LCD Cape BBB/Backup/2020-03-16/PCB1.PcbDoc
Electronic/PCB/LCD Cape BBB/Backup/2020-03-17/LCD Cape BBB.PrjPcb
Electronic/PCB/LCD Cape BBB/Backup/2020-03-17/LCD Cape.SchDoc
Electronic/PCB/LCD Cape BBB/Backup/2020-03-17/PCB1.PcbDoc
Electronic/PCB/LCD Cape BBB/Backup/2020-03-18/LCD Cape BBB.PrjPcb
Electronic/PCB/LCD Cape BBB/Backup/2020-03-18/LCD Cape.SchDoc
Electronic/PCB/LCD Cape BBB/Backup/2020-03-18/PCB1.PcbDoc
Electronic/PCB/Motor Driver/2020_03_26/Motor Driver/Motor Driver.PrjPcb
Electronic/PCB/Motor Driver/2020_03_26/Motor Driver/PCB1.PcbDoc
Electronic/PCB/Motor Driver/2020_03_26/Motor Driver/STM32.SchDoc
Electronic/PCB/Motor Driver/2020_03_26/Motor Driver/TMC2130.SchDoc
Electronic/PCB/Motor Driver/2020_03_26/Motor Driver/Top.SchDoc
Electronic/PCB/Motor Driver/BackUp/2020_03_03/Motor Driver.PrjPcb
Electronic/PCB/Motor Driver/BackUp/2020_03_03/PCB1.PcbDoc
Electronic/PCB/Motor Driver/BackUp/2020_03_03/STM32.SchDoc
Electronic/PCB/Motor Driver/BackUp/2020_03_03/TMC2130.SchDoc
Electronic/PCB/Motor Driver/BackUp/2020_03_04_15H/Motor Driver/Motor Driver.PrjPcb
Electronic/PCB/Motor Driver/BackUp/2020_03_04_15H/Motor Driver/PCB1.PcbDoc
Electronic/PCB/Motor Driver/BackUp/2020_03_04_15H/Motor Driver/STM32.SchDoc
Electronic/PCB/Motor Driver/BackUp/2020_03_04_15H/Motor Driver/TMC2130.SchDoc
Electronic/PCB/Motor Driver/BackUp/2020_03_04_23H/Motor Driver/Motor Driver.PrjPcb
Electronic/PCB/Motor Driver/BackUp/2020_03_04_23H/Motor Driver/PCB1.PcbDoc
Electronic/PCB/Motor Driver/BackUp/2020_03_04_23H/Motor Driver/STM32.SchDoc
Electronic/PCB/Motor Driver/BackUp/2020_03_04_23H/Motor Driver/TMC2130.SchDoc
Electronic/PCB/Motor Driver/BackUp/2020_03_05_16H/Motor Driver/Motor Driver.PrjPcb
Electronic/PCB/Motor Driver/BackUp/2020_03_05_16H/Motor Driver/PCB1.PcbDoc
Electronic/PCB/Motor Driver/BackUp/2020_03_05_16H/Motor Driver/STM32.SchDoc
Electronic/PCB/Motor Driver/BackUp/2020_03_05_16H/Motor Driver/TMC2130.SchDoc
Electronic/PCB/Motor Driver/BackUp/2020_03_05_22H/Motor Driver/Motor Driver.PrjPcb
Electronic/PCB/Motor Driver/BackUp/2020_03_05_22H/Motor Driver/PCB1.PcbDoc
Electronic/PCB/Motor Driver/BackUp/2020_03_05_22H/Motor Driver/STM32.SchDoc
Electronic/PCB/Motor Driver/BackUp/2020_03_05_22H/Motor Driver/TMC2130.SchDoc
Electronic/PCB/Motor Driver/BackUp/2020_03_06_18H/Motor Driver/Motor Driver.PrjPcb
Electronic/PCB/Motor Driver/BackUp/2020_03_06_18H/Motor Driver/PCB1.PcbDoc
Electronic/PCB/Motor Driver/BackUp/2020_03_06_18H/Motor Driver/STM32.SchDoc
Electronic/PCB/Motor Driver/BackUp/2020_03_06_18H/Motor Driver/TMC2130.SchDoc
Electronic/PCB/Motor Driver/BackUp/2020_03_06__23H/Motor Driver/Motor Driver.PrjPcb
Electronic/PCB/Motor Driver/BackUp/2020_03_06__23H/Motor Driver/PCB1.PcbDoc
Electronic/PCB/Motor Driver/BackUp/2020_03_06__23H/Motor Driver/STM32.SchDoc
Electronic/PCB/Motor Driver/BackUp/2020_03_06__23H/Motor Driver/TMC2130.SchDoc
Electronic/PCB/Motor Driver/BackUp/2020_03_07_13H/Motor Driver/Motor Driver.PrjPcb
Electronic/PCB/Motor Driver/BackUp/2020_03_07_13H/Motor Driver/PCB1.PcbDoc
Electronic/PCB/Motor Driver/BackUp/2020_03_07_13H/Motor Driver/STM32.SchDoc
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
