emilerenaud/6DOF-Robotic-Arm/(commit log)

2020-04-01 Google Drive Transfer
    Google Drive -> Gitub
    [BOM.xls, Copy of BOM.xls, Copy of Motor Driver.PrjPcb, Copy of PCB1.PcbDoc, Copy of PCB1.step, Copy of STM32.SchDoc, Copy of TMC2130.SchDoc, Forearm.STL]
2020-04-01 Revision PCB Motor Driver
    Revision PCB Motor Driver
    [PCB1.PcbDoc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]
2020-04-01 modified Project Structure
    [Driving Gear.stl, Forearm.STL, Gripper Case.stl, Joint To Axis.stl, Left Gripper.stl, Right Gripper.stl, Servo Cover.stl, TicBase.STL]
2020-04-01 deleted all config files
    [BOM.xls, Motor Driver.PrjPcb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]
2020-04-02 test git desktop
    [LCD Cape.SchDoc]
2020-04-02 Update PCB LCD Cape BBB
    [LCD Cape BBB.PrjPcb, PCB1.PcbDoc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]
2020-04-03 PCB Prep for manufacture
    [LCD Cape BBB.PrjPcb, Motor Driver.PrjPcb, PCB1.PcbDoc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]
2020-04-15 modified Motor Driver schematic (BOM)
    [BOM.xls, STM32.SchDoc, TMC2130.SchDoc]
2020-04-17 completed schematic and BOM
    [PCB1.PcbDoc, STM32.SchDoc, TMC2130.SchDoc]
2020-04-22 Update Library & BOM PCB Drive Motor
    [BOM-Motor_Driver_V0.1.xls, Motor Driver.PrjPcb, Motor Driver.SCHLIB, Motor Driver.xls, PCB1.PcbLib, STM32.SchDoc, TMC2130.SchDoc]
2020-04-27 Added Component
    [BOM.xls, Electronics-Components-Index.xlsx]
2020-04-28 Update PCB LIB
    [PCB1.PcbLib]
2020-04-30 update PCB Production
    [Electronics-Components-Index.xlsx, Motor Driver.PrjPcb]
2020-04-30 Added Library to Production PCB
    [Motor Driver.PrjPcb]
2020-04-30 Update Production PCB
    [STM32.SchDoc, TMC2130.SchDoc]
2020-04-30 Update Yves pt1
    [STM32.SchDoc, TMC2130.SchDoc, Top.SchDoc]
2020-05-01 Update Yves pt2
    [STM32.SchDoc, TMC2130.SchDoc]
